haibv10/spin-coater/stm32f103c8/protocol_uart/convert.c

#include "convert.h"

/**
 * @name convert_from_float_to_bytes
 * @brief Chuyen doi tu float sang mang byte
 * @param data: Gia tri float can chuyen doi
 * @return Mang byte sau khi chuyen doi
 */
uint8_t *convert_from_float_to_bytes(float data)
{
	static float_bytes input_convert;
	input_convert.data_float = data;
	return input_convert.byte;
}

/**
 * @name convert_from_bytes_to_float
 * @brief Chuyen doi tu mang byte sang float
 * @param data0: Byte 0
 * @param data1: Byte 1
 * @param data2: Byte 2
 * @param data3: Byte 3
 * @return Gia tri float sau khi chuyen doi
 */
float convert_from_bytes_to_float(uint8_t data0, uint8_t data1, uint8_t data2, uint8_t data3)
{
	float_bytes input_convert;
	input_convert.byte[0] = data0;
	input_convert.byte[1] = data1;
	input_convert.byte[2] = data2;
	input_convert.byte[3] = data3;
	return input_convert.data_float;
}

/**
 * @name convert_from_int_to_bytes
 * @brief Chuyen doi tu uint32_t sang mang byte
 * @param data: Gia tri uint32_t can chuyen doi
 * @return Mang byte sau khi chuyen doi
 */
uint8_t *convert_from_int_to_bytes(uint32_t data)
{
	static int_bytes input_convert;
	input_convert.data_int = data;
	return input_convert.byte;
}

/**
 * @name convert_from_bytes_to_int
 * @brief Chuyen doi tu mang byte sang uint32_t
 * @param data0: Byte 0
 * @param data1: Byte 1
 * @param data2: Byte 2
 * @param data3: Byte 3
 * @return Gia tri uint32_t sau khi chuyen doi
 */
uint32_t convert_from_bytes_to_int(uint8_t data0, uint8_t data1, uint8_t data2, uint8_t data3)
{
	int_bytes input_convert;
	input_convert.byte[0] = data0;
	input_convert.byte[1] = data1;
	input_convert.byte[2] = data2;
	input_convert.byte[3] = data3;
	return input_convert.data_int;
}

/**
 * @name convert_from_u16_to_bytes
 * @brief Chuyen doi tu uint16_t sang mang byte
 * @param data: Gia tri uint16_t can chuyen doi
 * @return Mang byte sau khi chuyen doi
 */
uint8_t *convert_from_u16_to_bytes(uint16_t data)
{
	static u16_bytes input_convert;
	input_convert.data_u16 = data;
	return input_convert.byte;
}

/**
 * @name convert_from_bytes_to_u16
 * @brief Chuyen doi tu mang byte sang uint16_t
 * @param data0: Byte 0
 * @param data1: Byte 1
 * @return Gia tri uint16_t sau khi chuyen doi
 */
uint16_t convert_from_bytes_to_u16(uint8_t data0, uint8_t data1)
{
	u16_bytes input_convert;
	input_convert.byte[0] = data0;
	input_convert.byte[1] = data1;
	return input_convert.data_u16;
}

/**
 * @name convert_from_bytes_to_u8
 * @brief Chuyen doi tu byte sang uint8_t
 * @param data: Byte can chuyen doi
 * @return Gia tri uint8_t sau khi chuyen doi
 */
uint8_t convert_from_bytes_to_u8(uint8_t data) { return data; }
